HestiaPi/hestia-touch-pcb-dev/(notices)

Notices in the files:
HestiaPi-ONE/KiCAD/HestiaPiOneUniversal.kicad_pcb:
License: CC BY-SA
